abdullahcanakci/clock/English_Schematic.pdf

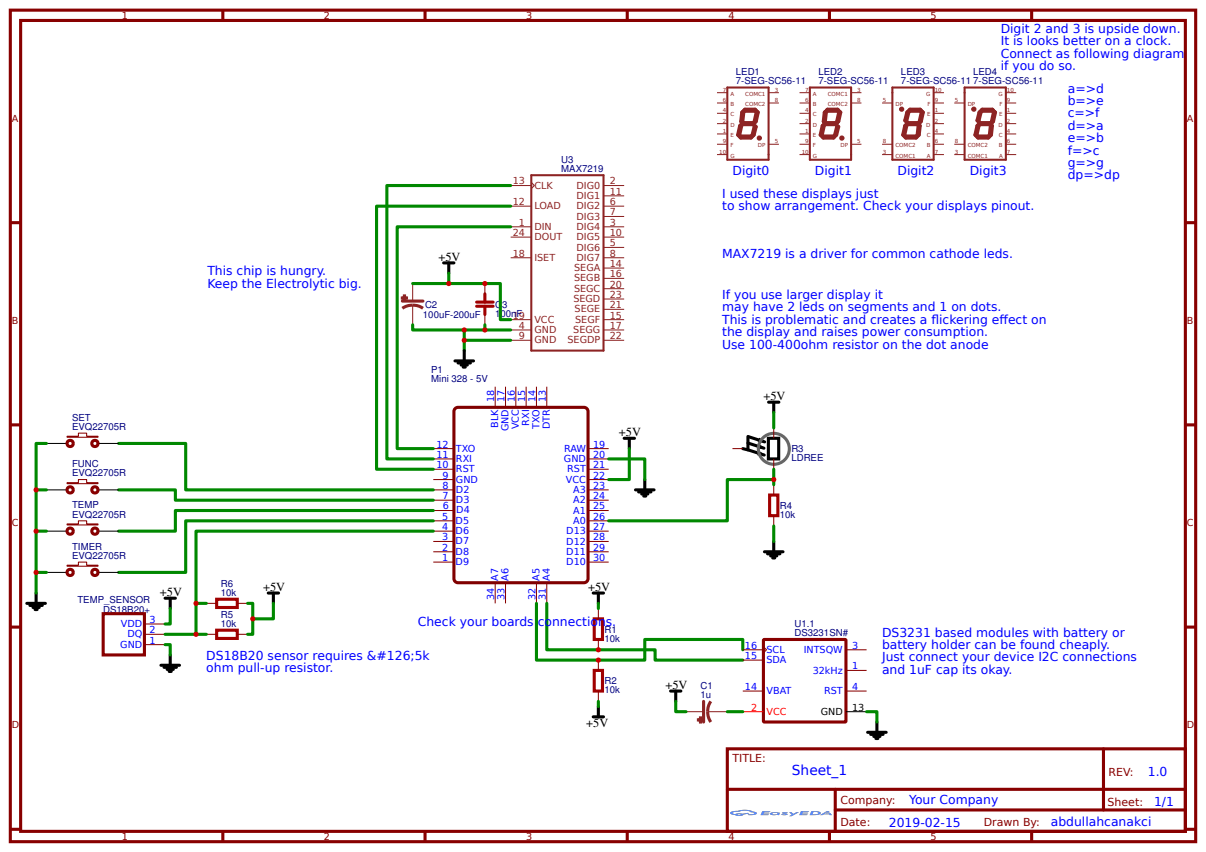
[picture p1: page 1]

Digit 2 and 3 is upside down.
It is looks better on a clock.
Connect as following diagram
if you do so.
LED4
7-SEG-SC56-11

MAX7219 is a driver for common cathode leds.

This chip is hungry.
Keep the Electrolytic big.

If you use larger display it
may have 2 leds on segments and 1 on dots.
This is problematic and creates a flickering effect on
the display and raises power consumption.
Use 100-400ohm resistor on the dot anode

DTR 13 TXO 14 RXI 15 VCC 16 GND 17 BLK 18

Check your boards connections.

DS3231 based modules with battery or
battery holder can be found cheaply.
Just connect your device I2C connections
and 1uF cap its okay.

DS18B20 sensor requires &#126;5k
ohm pull-up resistor.
