abdullahcanakci/clock/Türkçe_Şematik.pdf

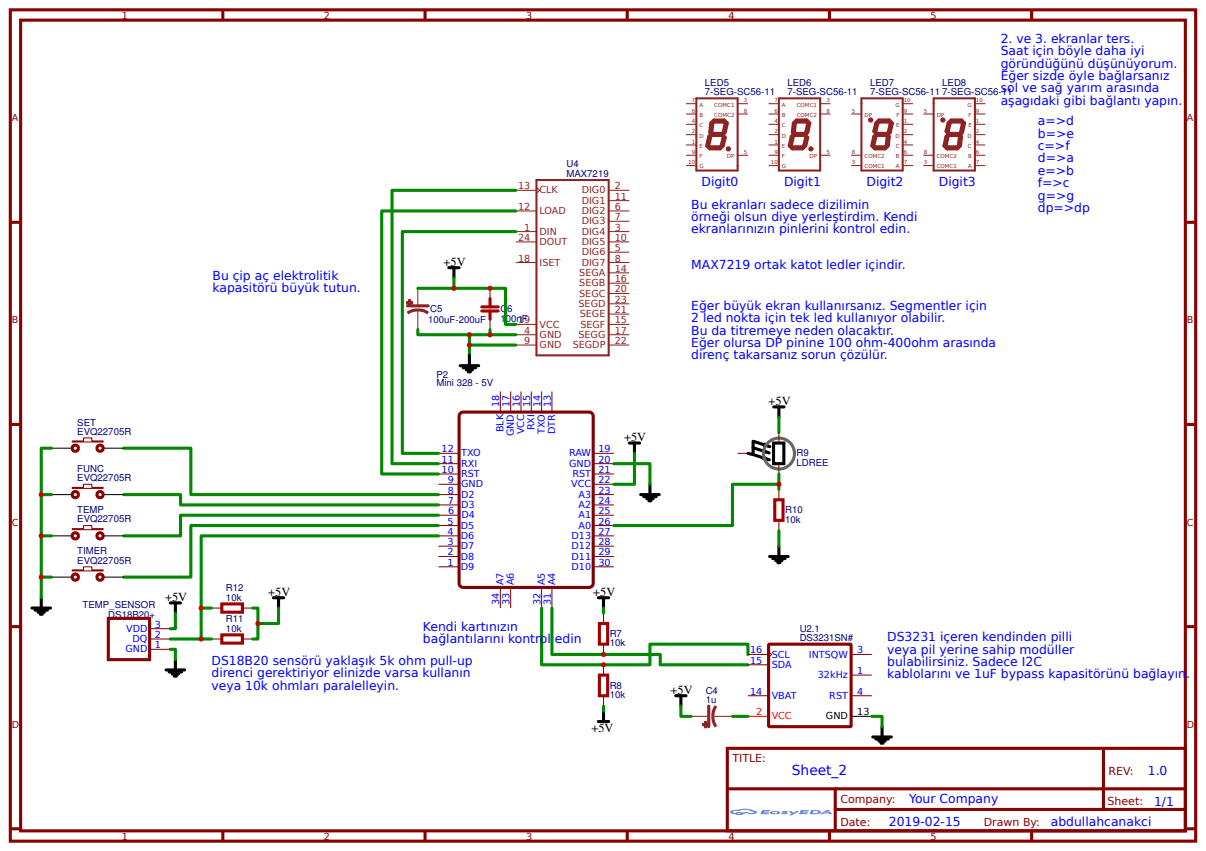
[picture p2: page 1]

MAX7219 ortak katot ledler içindir.

Bu çip aç elektrolitik
kapasitörü büyük tutun.

Eğer büyük ekran kullanırsanız. Segmentler için
2 led nokta için tek led kullanıyor olabilir.
Bu da titremeye neden olacaktır.
Eğer olursa DP pinine 100 ohm-400ohm arasında
direnç takarsanız sorun çözülür.

DTR 13 TXO 14 RXI 15 VCC 16 GND 17 BLK 18

DS3231 içeren kendinden pilli
veya pil yerine sahip modüller
bulabilirsiniz. Sadece I2C
kablolarını ve 1uF bypass kapasitörünü bağlayın.

DS18B20 sensörü yaklaşık 5k ohm pull-up
direnci gerektiriyor elinizde varsa kullanın
veya 10k ohmları paralelleyin.
