abdullahcanakci/clock/(threads)

Thread 1 (2019-02-18):

Problem connecting DS3231

abdullahcanakci, 2019-02-18:
DS3231 is connected to the 5V rail by 1uF bypass capacitor. After power cycle problem occurs.
- Power off
- Power on
- Display comes on with random data for a moment.
- Display clears.
What I think happening is RTC chip
- Starts using battery power after power off,
- Power comes on,
- Chip access requested, (Not accessible)
- Capacitor voltage rises enough to disable battery mode of the display.
- Chip accessible (I think) but boot completed already and no more tries to connect.
