abdullahcanakci/clock/(commit log)

2019-02-08 temp button is working
2019-02-08 fixed timer, timer, temp buttons are working
2019-02-08 Fixed an issue where timer wasn't blinking. Implemented Timer 'stop', 'run' and 'paused' states nicely.
2019-02-09 implmented button multifunctions\n using 1 display buffer instead of multiple purpose spesific ones
2019-02-13 fixed an issue where timer didnt response right to buttons
2019-02-14 Problem with flickering is caused by single led dot. Fixed it by applying 500ohm resistor inline with it. Reintegrated auto intensity setting
2019-02-15 Added schematics. Updated readme
2019-02-15 Somehow messed up the schematics.
2019-02-17 Temp conversion issue fixed
    Fixed an issue when temperature conversion requested and temperature requested back to back leading to chip dumping default data.
    Fixed blocking in temp parsing method. Now it ask the chip for conversion completion.
    [clock.ino]
2019-02-18 Set error fix, temp over request fix, LDR enable integration
    There was an error where a reserved word used for variable name and this caused halt on SET menu exit.
    Temperature conversion was checked on every loop and this caused temp rise on sensor chip. added an extra control and variable to set check interval.
    Implemented LDR enable. this way users change of brightness on settings will persist and no pin enable and reads are done on them
    [clock.ino]
2019-02-19 Implemented LDR disable, EEPROM setting persistance
    Brightness setting set through SET mode will persist through reboot.
    [clock.ino]
2019-02-20 Preprocessor compile rollback
    Preprocessor compile worked on test board with RTC_Millis, but on actual device it didn't.
    [clock.ino]
